angrypig7/NEO3DS-nRF52-PCB/Pics/V1.1/nRF52-BLEUart-module-USB.png

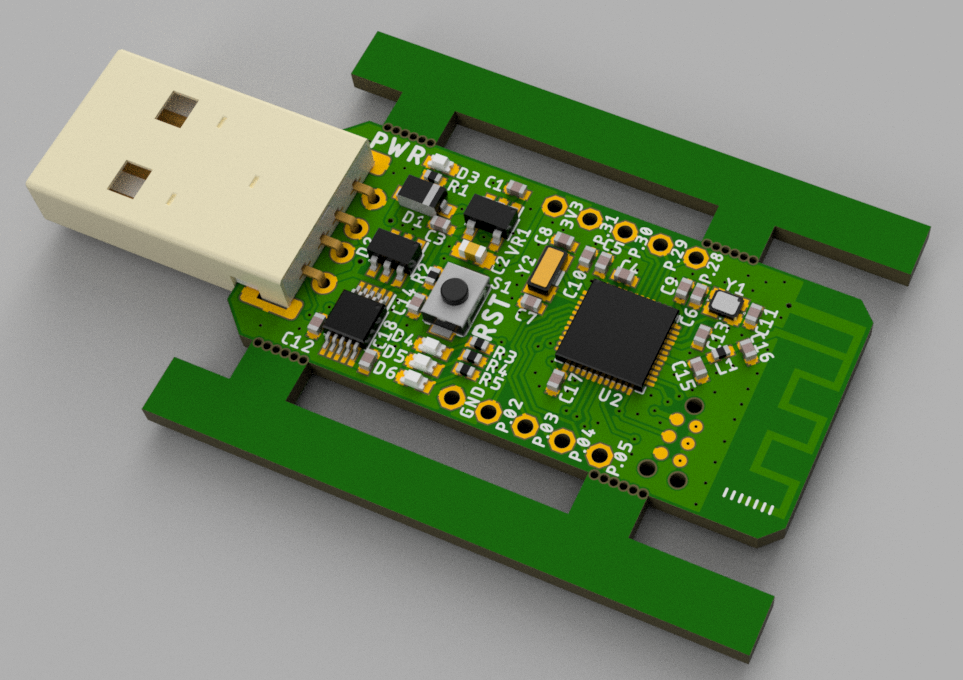
Pics/V1.1/nRF52-BLEUart-module-USB.png
