angrypig7/NEO3DS-nRF52-PCB/Pics/V1.1/2.jpg

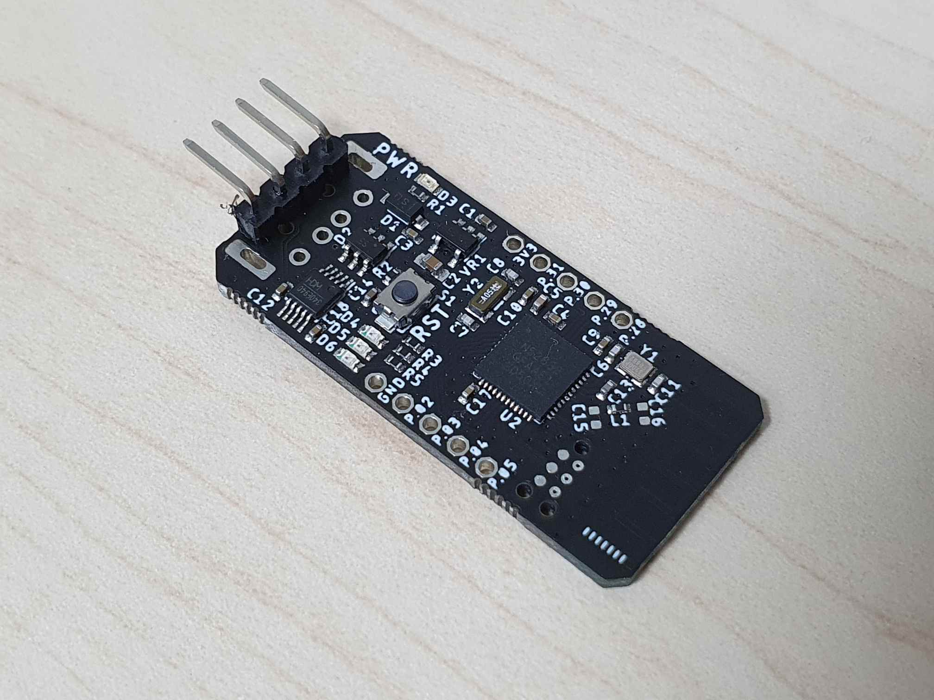
Pics/V1.1/2.jpg
