angrypig7/NEO3DS-nRF52-PCB/_Output/PCB pictures/board-bottom-view.png

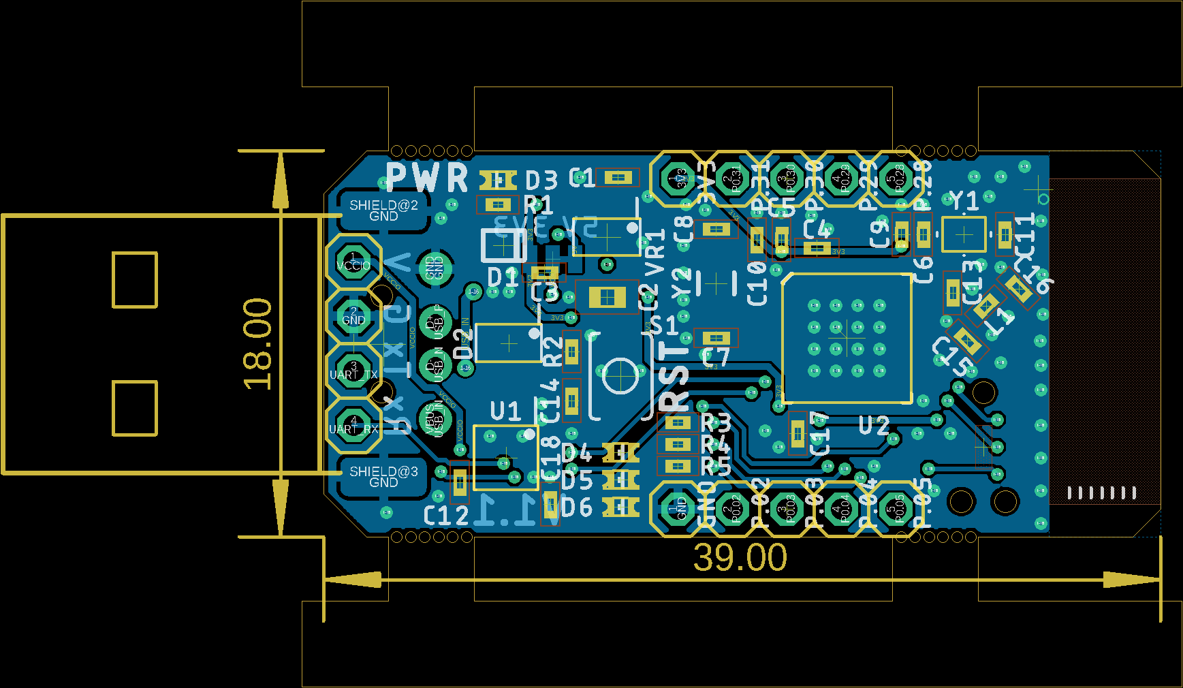
_Output/PCB pictures/board-bottom-view.png
