angrypig7/NEO3DS-nRF52-PCB/nRF52-BLEUart-module v34.png

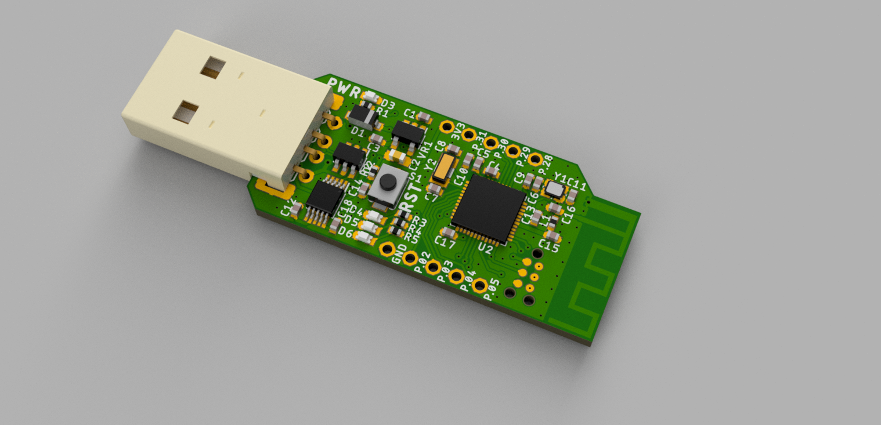
nRF52-BLEUart-module v34.png
