angrypig7/NEO3DS-nRF52-PCB/Pics/V1.1/1.jpg

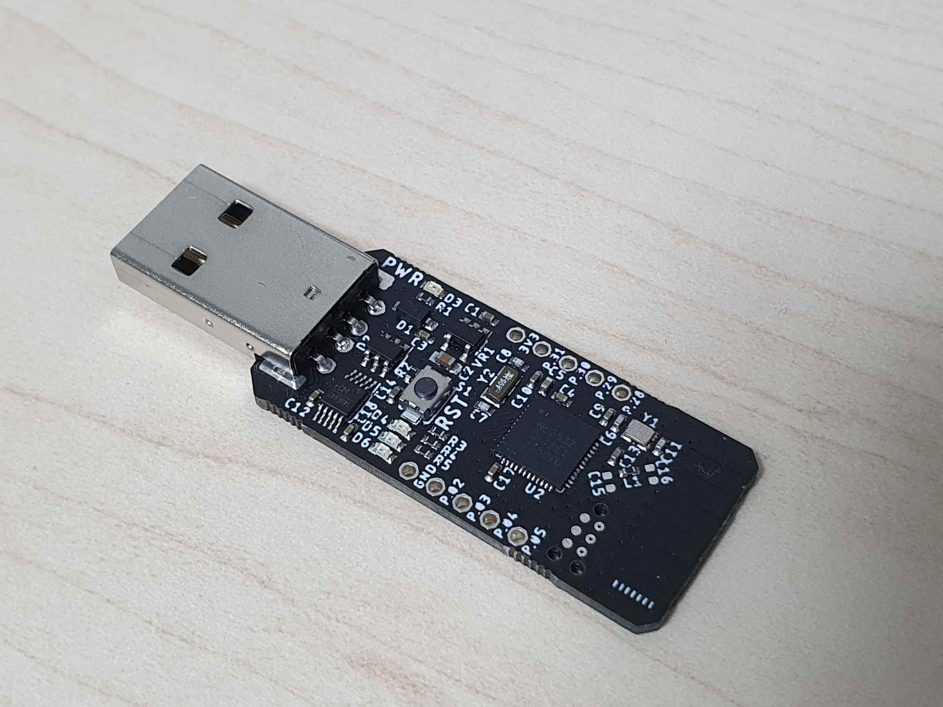
Pics/V1.1/1.jpg
