angrypig7/NEO3DS-nRF52-PCB/_Output/schematic.pdf

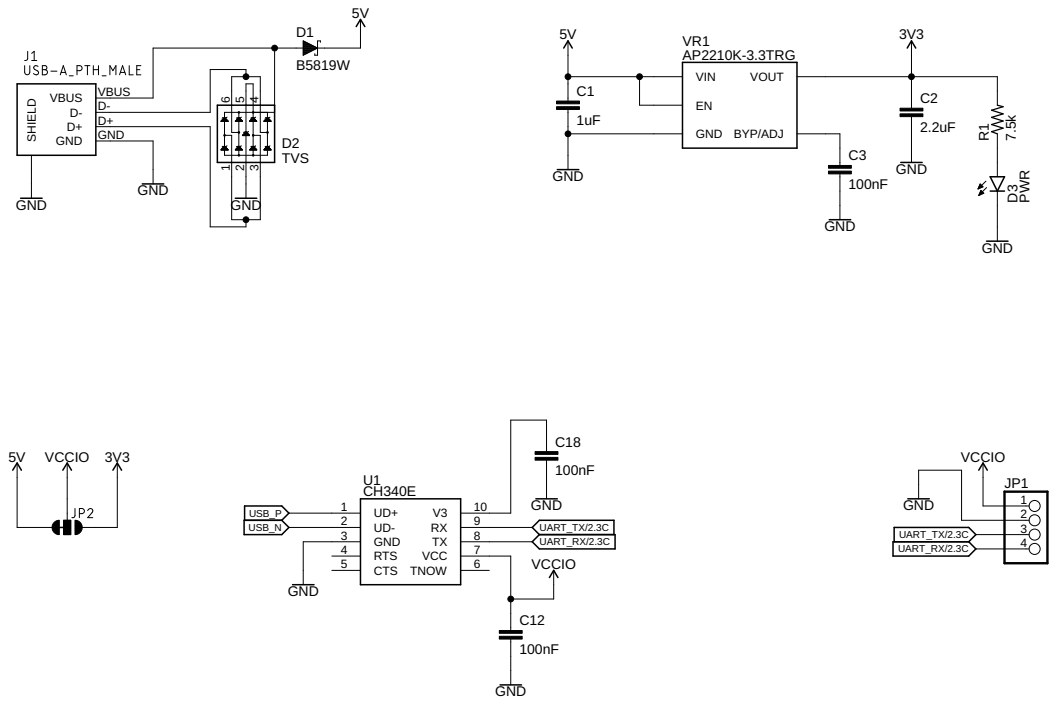
[picture p6: page 1]

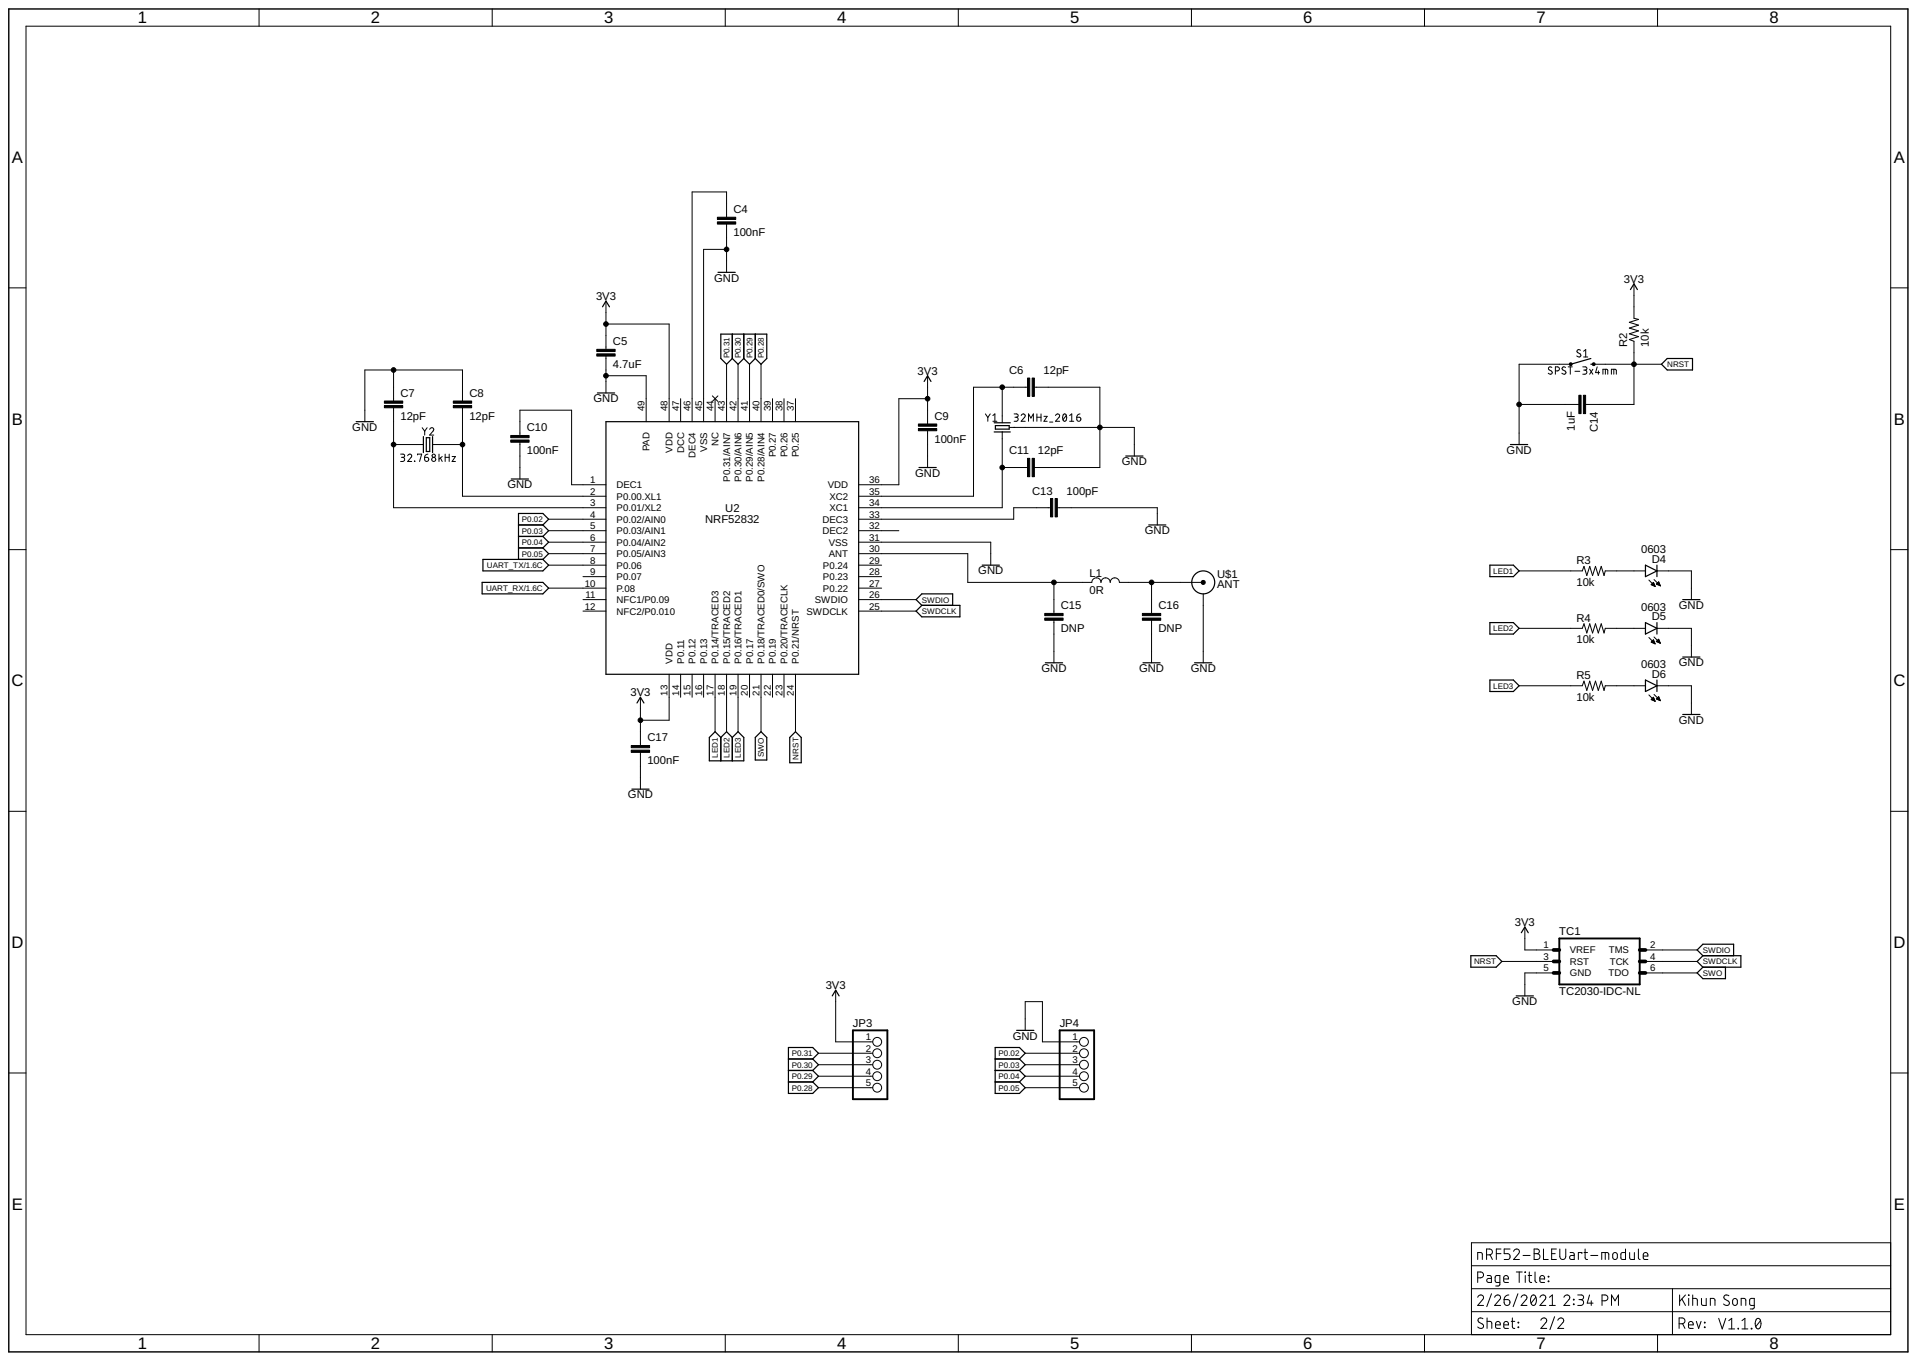
[picture p7: page 2]
