angrypig7/NEO3DS-nRF52-PCB/PCB/board.brd

## EAGLE design PCB/board.brd (2021-05-04)

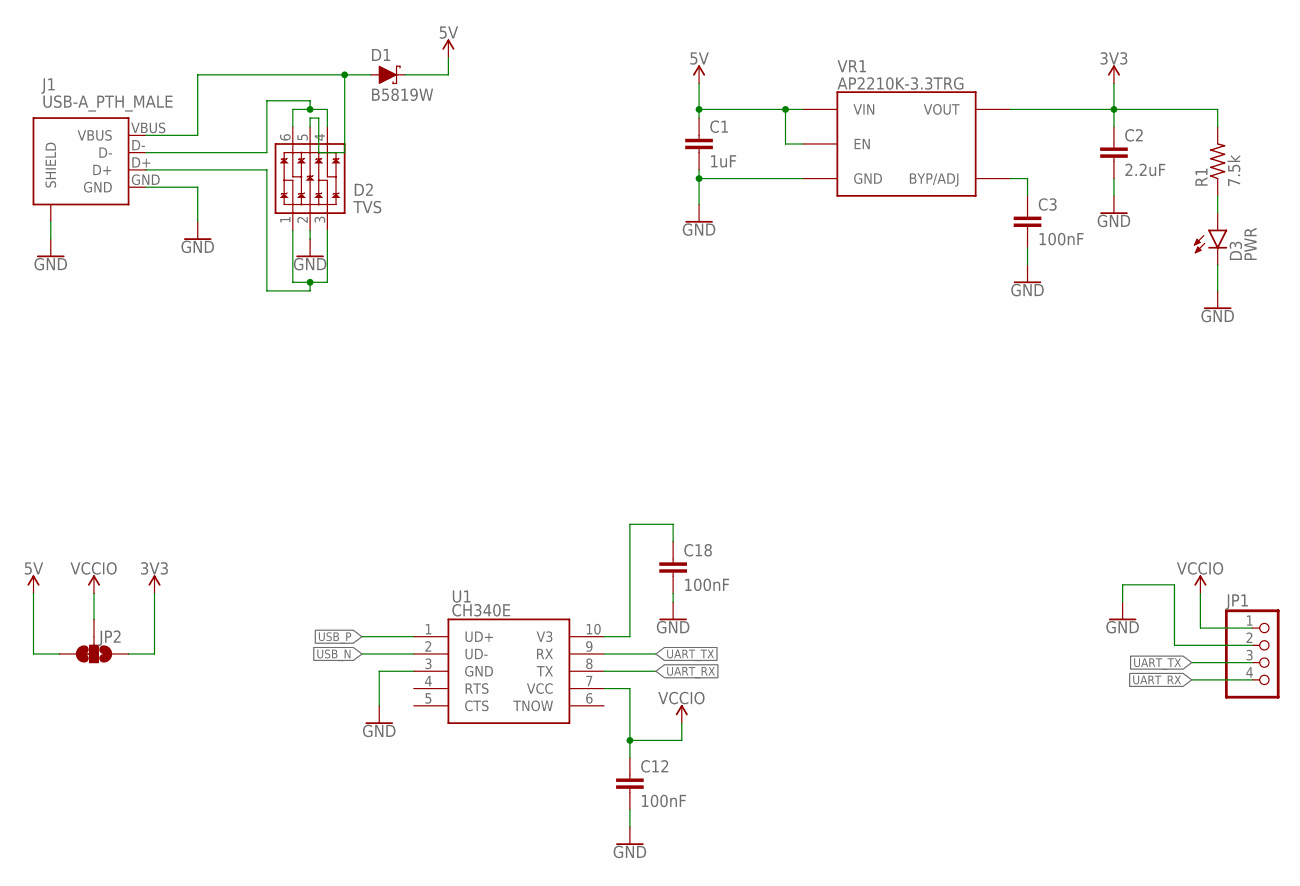
[picture p8: schematic board.sch, sheet 1]

Parts:
C1: 1uF; C0402; LCSC C52923
C2: 2.2uF; C0603; LCSC C23630
C3, C12, C18: 100nF; C0402; LCSC C1525
D1: B5819W; SOD-123; LCSC C8598
D2: TVS; SPT-23-6; LCSC C85364
D3: PWR; LED_0603; LCSC C72038
J1: USB-A_PTH_MALE; USB-A-MALE-H-PTH-1; LCSC C9739
JP1: Rx Tx G V; 1X04-NOSILK
JP2: 5V 3V3; SMT-JUMPER_3_1-NC_TRACE_NO-SILK
R1: 7.5k; R0402; LCSC C25918
U1: CH340E; MSOP-10; LCSC C99652
VR1: AP2210K-3.3TRG; SOT-23-5; LCSC C176959

Connections:
3V3: C2.1, JP2.1, R1.2, VR1.5 (VOUT); also elsewhere on the board
5V: C1.1, D1.C, JP2.3, VR1.1 (VIN), VR1.3 (EN)
GND: C1.2, C2.2, C3.2, C12.2, C18.2, D2.2 (VSS), D3.C, J1.GND, J1.SHIELD@0 (SHIELD), J1.SHIELD@1 (SHIELD), J1.SHIELD@2 (SHIELD), J1.SHIELD@3 (SHIELD), JP1.2, U1.3 (GND), VR1.2 (GND); also elsewhere on the board
unnamed: C3.1, VR1.4 (BYP/ADJ)
unnamed: D3.A, R1.1
unnamed: C18.1, U1.10 (V3)
UART_RX: JP1.4, U1.8 (TX); also elsewhere on the board
UART_TX: JP1.3, U1.9 (RX); also elsewhere on the board
USB_IN: D1.A, D2.5 (VCC), J1.VBUS
USB_N: D2.4 (IO3), D2.6 (IO4), J1.D-, U1.2 (UD-)
USB_P: D2.1 (IO1), D2.3 (IO2), J1.D+, U1.1 (UD+)
VCCIO: C12.1, JP1.1, JP2.2, U1.7 (VCC)

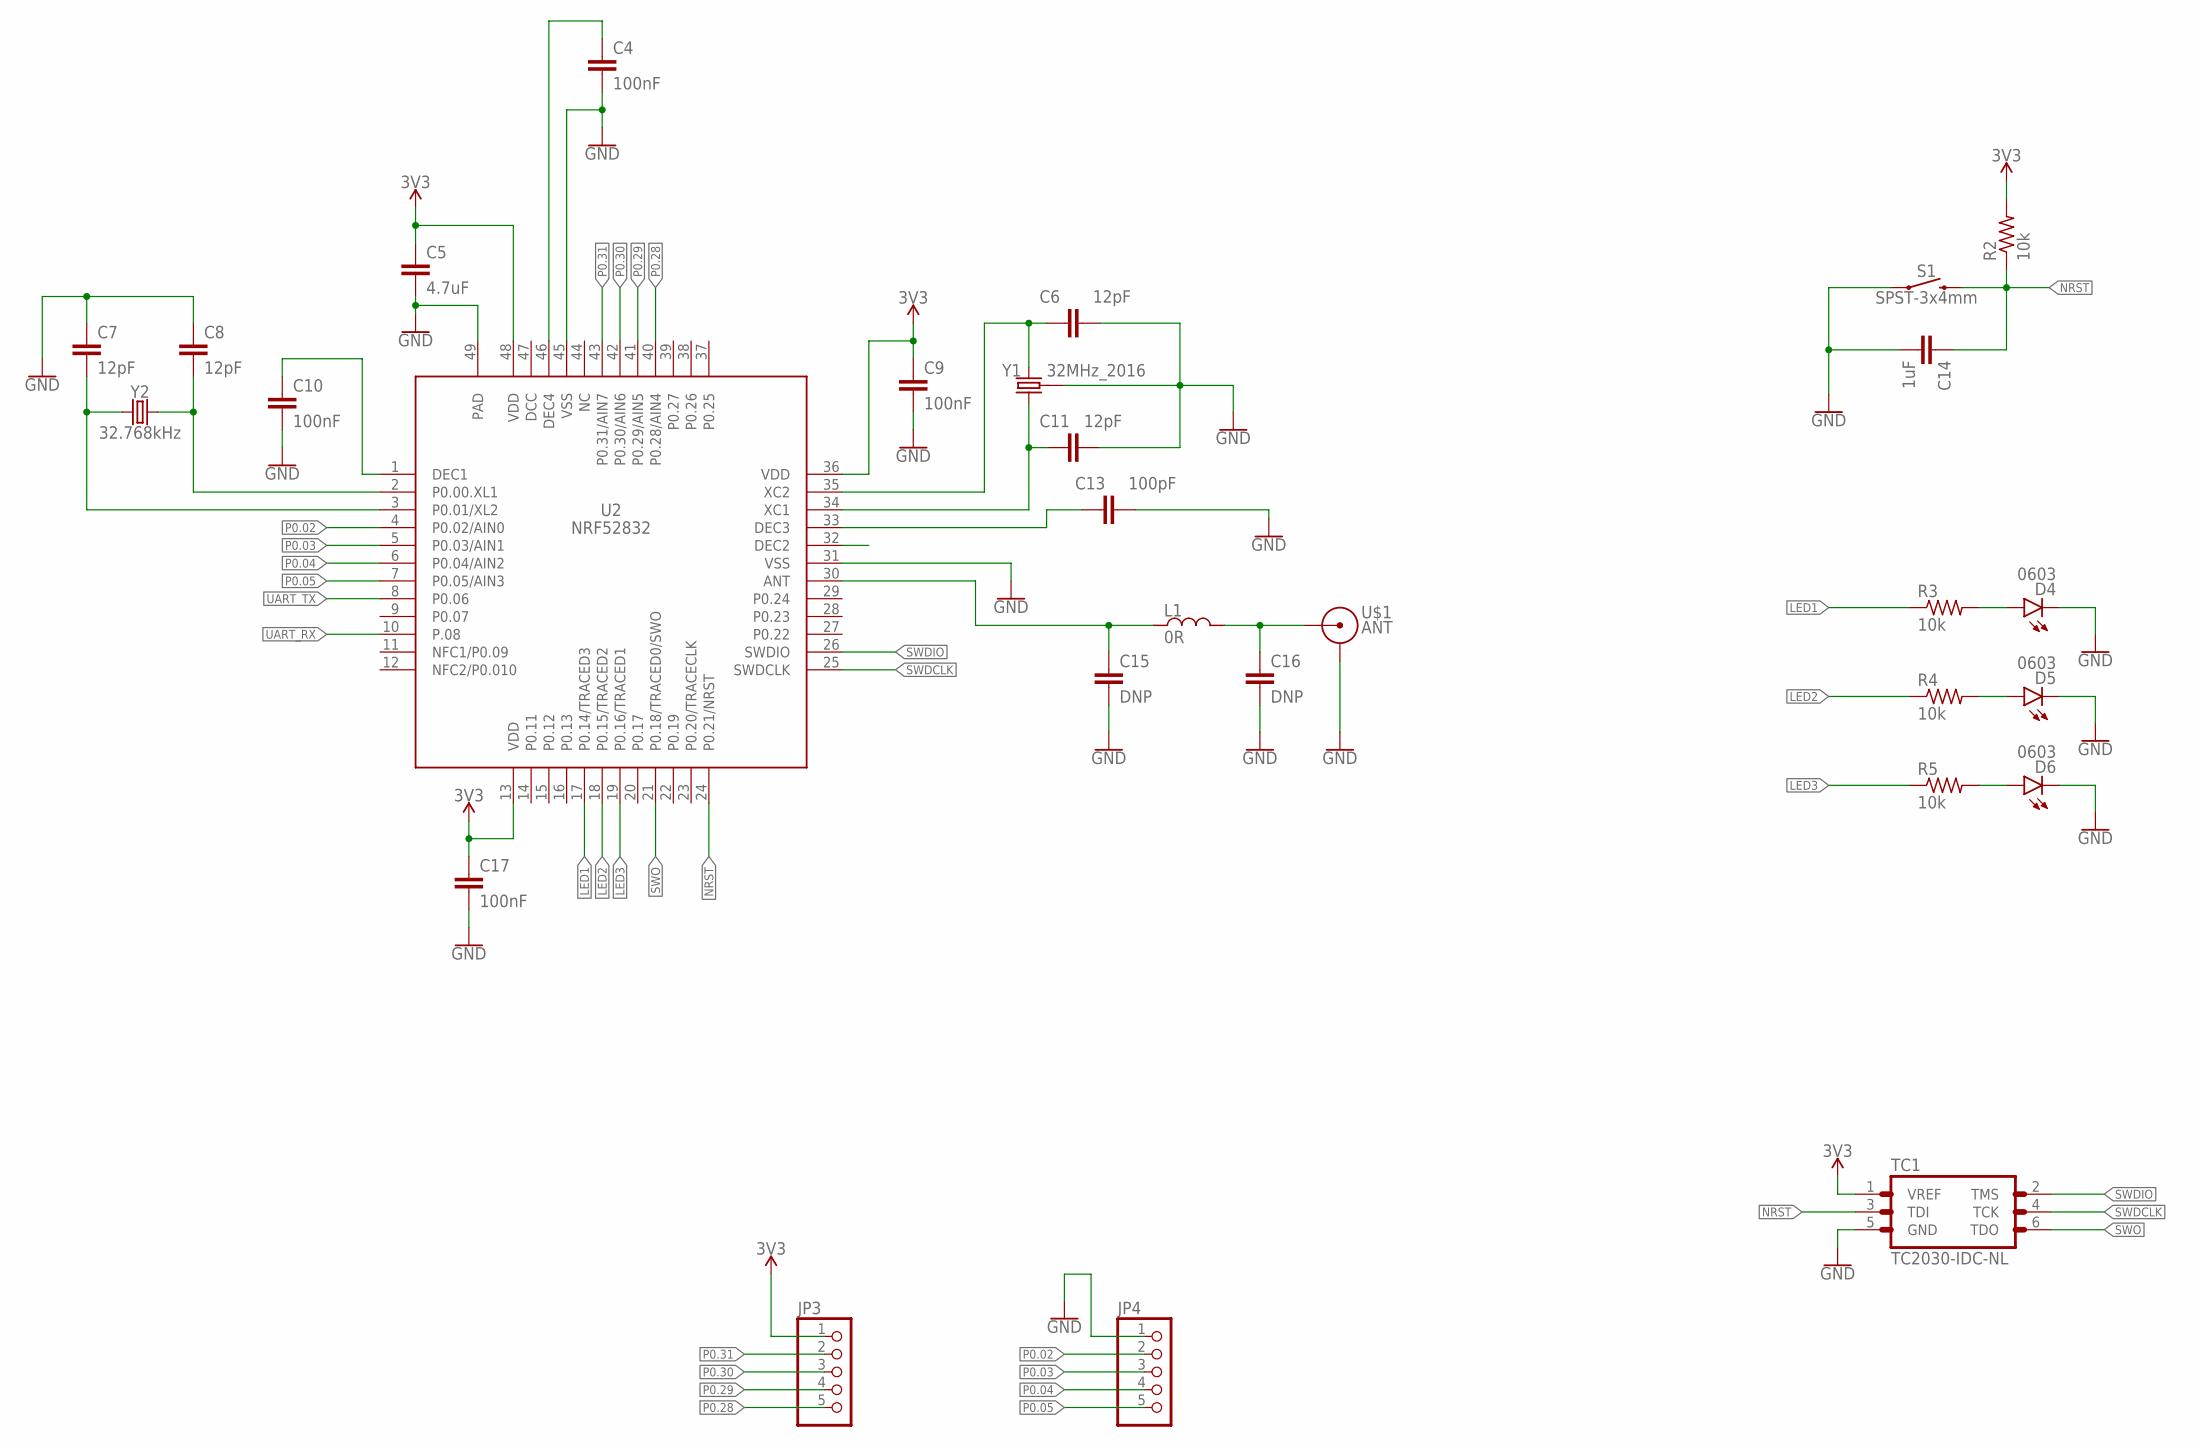
[picture p9: schematic board.sch, sheet 2]

Parts:
C4, C9, C10, C17: 100nF; C0402; LCSC C1525
C5: 4.7uF; C0402; LCSC C23733
C6, C7, C8, C11: 12pF; C0402; LCSC C1547
C13: 100pF; C0402; LCSC C1546
C14: 1uF; C0402; LCSC C52923
C15, C16: DNP; C0402
D4, D5, D6: 0603; LED_0603; LCSC C2286
JP3, JP4: PINHD-1X5-NOSILK; 1X05-NOSILK
L1: 0R; R0402; LCSC C17168
R2, R3, R4, R5: 10k; R0402; LCSC C25744
S1: SPST-3x4mm; TACTILE_SWITCH_SMD_3.0X4.0MM; LCSC C720477
TC1: TC2030-IDC-NL
U2: NRF52832; QFN40P600X600X90-49T450N; JLC_ROTATION 270
U$1: ANT; TI-AN043_LEFT_SHORTER
Y1: 32MHz_2016; CRYSTAL-SMD-2.0X1.6MM; LCSC C255896
Y2: 32.768kHz; CRYSTAL-SMD-3.2X1.5MM; LCSC C32346

Connections:
3V3: C5.1, C9.1, C17.1, JP3.1, R2.2, TC1.1 (VREF), U2.13 (VDD), U2.36 (VDD), U2.48 (VDD); also elsewhere on the board
GND: C4.2, C5.2, C6.2, C7.1, C8.1, C9.2, C10.2, C11.2, C13.2, C14.2, C15.2, C16.2, C17.2, D4.C, D5.C, D6.C, JP4.1, S1.1, TC1.5 (GND), U2.31 (VSS), U2.45 (VSS), U2.49 (PAD), U$1.GND, Y1.2 (GND), Y1.4 (GND); also elsewhere on the board
LED1: R3.1, U2.17 (P0.14/TRACED3)
LED2: R4.1, U2.18 (P0.15/TRACED2)
LED3: R5.1, U2.19 (P0.16/TRACED1)
unnamed: C8.2, U2.2 (P0.00.XL1), Y2.P$2 (2)
unnamed: D4.A, R3.2
unnamed: C7.2, U2.3 (P0.01/XL2), Y2.P$1 (1)
unnamed: C10.1, U2.1 (DEC1)
unnamed: C4.1, U2.46 (DEC4)
unnamed: C6.1, U2.35 (XC2), Y1.3 (2)
unnamed: C11.1, U2.34 (XC1), Y1.1
unnamed: C13.1, U2.33 (DEC3)
unnamed: D5.A, R4.2
unnamed: D6.A, R5.2
NRST: C14.1, R2.1, S1.2, TC1.3 (TDI), U2.24 (P0.21/NRST)
P0.02: JP4.2, U2.4 (P0.02/AIN0)
P0.03: JP4.3, U2.5 (P0.03/AIN1)
P0.04: JP4.4, U2.6 (P0.04/AIN2)
P0.05: JP4.5, U2.7 (P0.05/AIN3)
P0.28: JP3.5, U2.40 (P0.28/AIN4)
P0.29: JP3.4, U2.41 (P0.29/AIN5)
P0.30: JP3.3, U2.42 (P0.30/AIN6)
P0.31: JP3.2, U2.43 (P0.31/AIN7)
RF-1: C15.1, L1.1, U2.30 (ANT)
RF-2: C16.1, L1.2, U$1.RF (FEED)
SWDCLK: TC1.4 (TCK), U2.25 (SWDCLK)
SWDIO: TC1.2 (TMS), U2.26 (SWDIO)
SWO: TC1.6 (TDO), U2.21 (P0.18/TRACED0/SWO)
UART_RX: U2.10 (P.08); also elsewhere on the board
UART_TX: U2.8 (P0.06); also elsewhere on the board

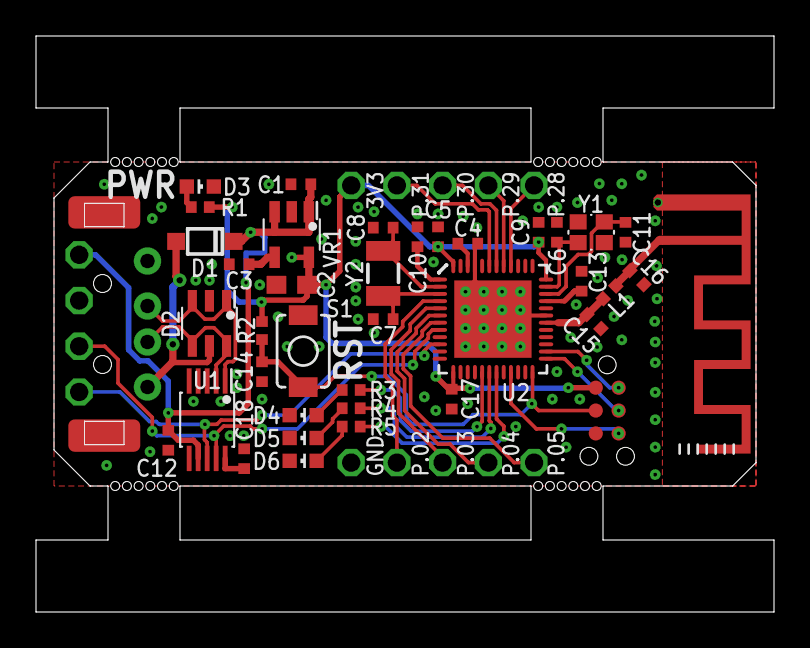
[picture p10: board board.brd from above]

Board: 2 copper layers, 41.0 x 32.0 mm, 43 parts (1 on the bottom side), 39 nets.
