angrypig7/NEO3DS-nRF52-PCB/(threads)

Thread 1 (2021-01-12):

remove nRST pull-up resistor

angrypig7, 2021-01-12:

angrypig7, 2021-03-05:
fixed

Closed 2021-03-05.

Thread 5 (2021-02-05):

Check UART pin header orientation

angrypig7, 2021-02-05:

angrypig7, 2021-03-05:
fixed

Closed 2021-03-05.

Thread 6 (2021-02-09):

GND via on C2 sucking solder away

angrypig7, 2021-02-09:

angrypig7, 2021-03-05:
fixed

Closed 2021-03-05.

Thread 7 (2021-02-10):

USB connector footprint too tight

angrypig7, 2021-02-10:

Closed 2021-03-05.
