angrypig7/NEO3DS-nRF52-PCB/(commit log)

2021-01-06 PCB files
    [board.brd, board.sch]
2021-01-06 seperated nRF52832 docs
    [nRF52832-MDK_3D_STEP_V2.0.step]
2021-01-06 PCB update
    [board.brd, board.sch]
2021-01-11 PCB update with inverted F antenna
    [board-Panel.brd, board-Panel_top_bom.csv, board.brd, board.sch, board_top_bom.csv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]
2021-01-13 artwork partially done, layout update
    [board.brd, board.sch]
2021-01-13 finished PCB artwork
    [board.brd, board.sch]
2021-01-13 fixed serial IO voltage, added GPIO silk
    [board.brd]
2021-01-13 PCB bug fixes, added production files
    [board.brd, board.sch, board_top_bom.csv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]
2021-01-31 fixed #4
    [board.brd]
2021-01-31 fixed #2, removed unecessary power test pad
    [board.brd, board.sch]
2021-01-31 added edge rails, mousebites to the PCB. DRC error fixes needed
    [board.brd]
2021-02-01 PCB artwork, gerbers and production files - part rotation needs fixes
    [board.brd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]
2021-02-01 final PCB for V1.0
    [board-Panel.brd, board-Panel_top_bom.csv, board.brd, board.sch, board_top_bom.csv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]
2021-02-17 V1.1.0 update
    [BOM-BLE-Uart-Dongle.xlsx, board.brd, board.sch, board_top_bom.csv, bom.csv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]
2021-02-24 output files, dir cleanup
    [BOM-BLE-Uart-Dongle.xlsx, board-Panel.brd, board-Panel_top_bom.csv, board.brd, board.sch, board_top_bom.csv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]
2021-02-26 airwire error fix
    [board-Panel.brd, board-Panel_top_bom.csv, board.brd, board.sch, bom.csv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]
2021-02-26 V1.1.0 output files
    [BOM-BLE-Uart-Dongle.xlsx, BOM-BLEUART-Module.xlsx, BOM-BLEUART-USB-Dongle.xlsx, board.brd, board.sch, bom.csv, mount_SMD.xlsx]
2021-03-05 fixed #7, replaced USB connector part.# on BOM
    [BOM-BLEUART-USB-Dongle.xlsx, board.brd, board.sch, board_top_bom.csv, bom.csv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]
2021-03-27 RF test report
    [board.brd]
2021-05-04 PCB trace width DFM
    [board.brd, board.sch]
